Joho-an/Tennis-Robot/BTgamepad/引脚定义.png

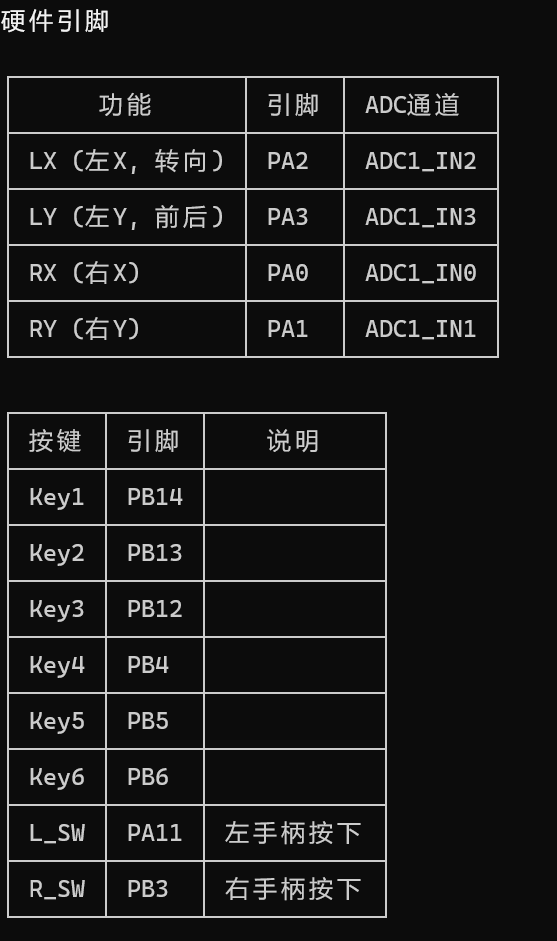
BTgamepad/引脚定义.png
