Joho-an/Tennis-Robot/BTgamepad/蓝牙指令1.png

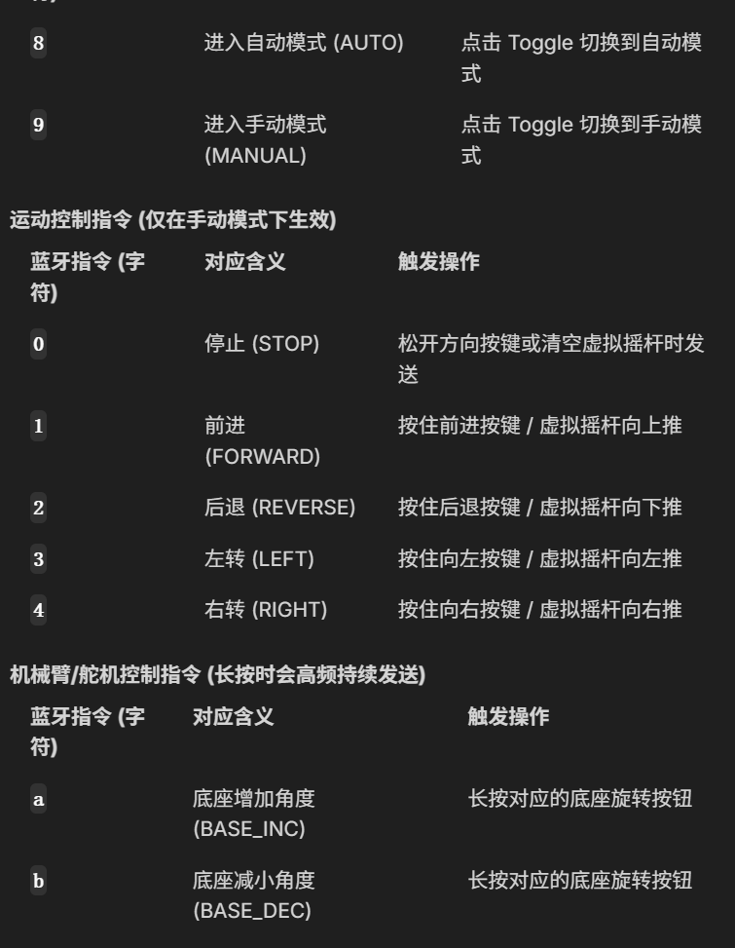
BTgamepad/蓝牙指令1.png
