Joho-an/Tennis-Robot/BTgamepad/蓝牙指令2.png

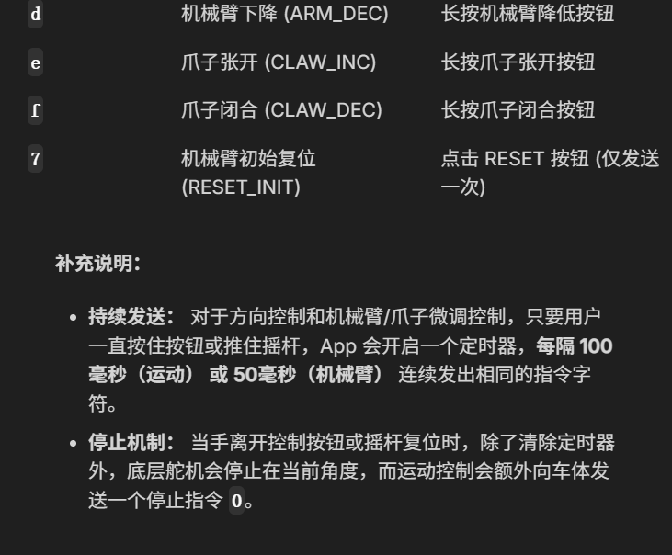
BTgamepad/蓝牙指令2.png
