Joho-an/Tennis-Robot/PCB/原理图.pdf

VSS 10 VDD 11 PH0-OSC_IN 12 PH1-OSC_OUT 13 NRST 14 PC0 15 PC1 16 PC2_C 17 PC3_C 18 VSSA 19 VREF+ 20 VDDA 21 PA0 22 PA1 23 PA2 24 PA3 25 VSS 26 VDD 27 PA4 28 PA5 29 PA6 30 PA7 31 PC4 32 PC5 33 PB0 34 PB1 35 PB2 36 PE7 37 PE8 38 PE9 39 PE10 40 PE11 41 PE12 42 PE13 43 PE14 44 PE15 45 PB10 46 PB11 47 VCAP 48 VSS 49 VDD 50 PB12 51

供电

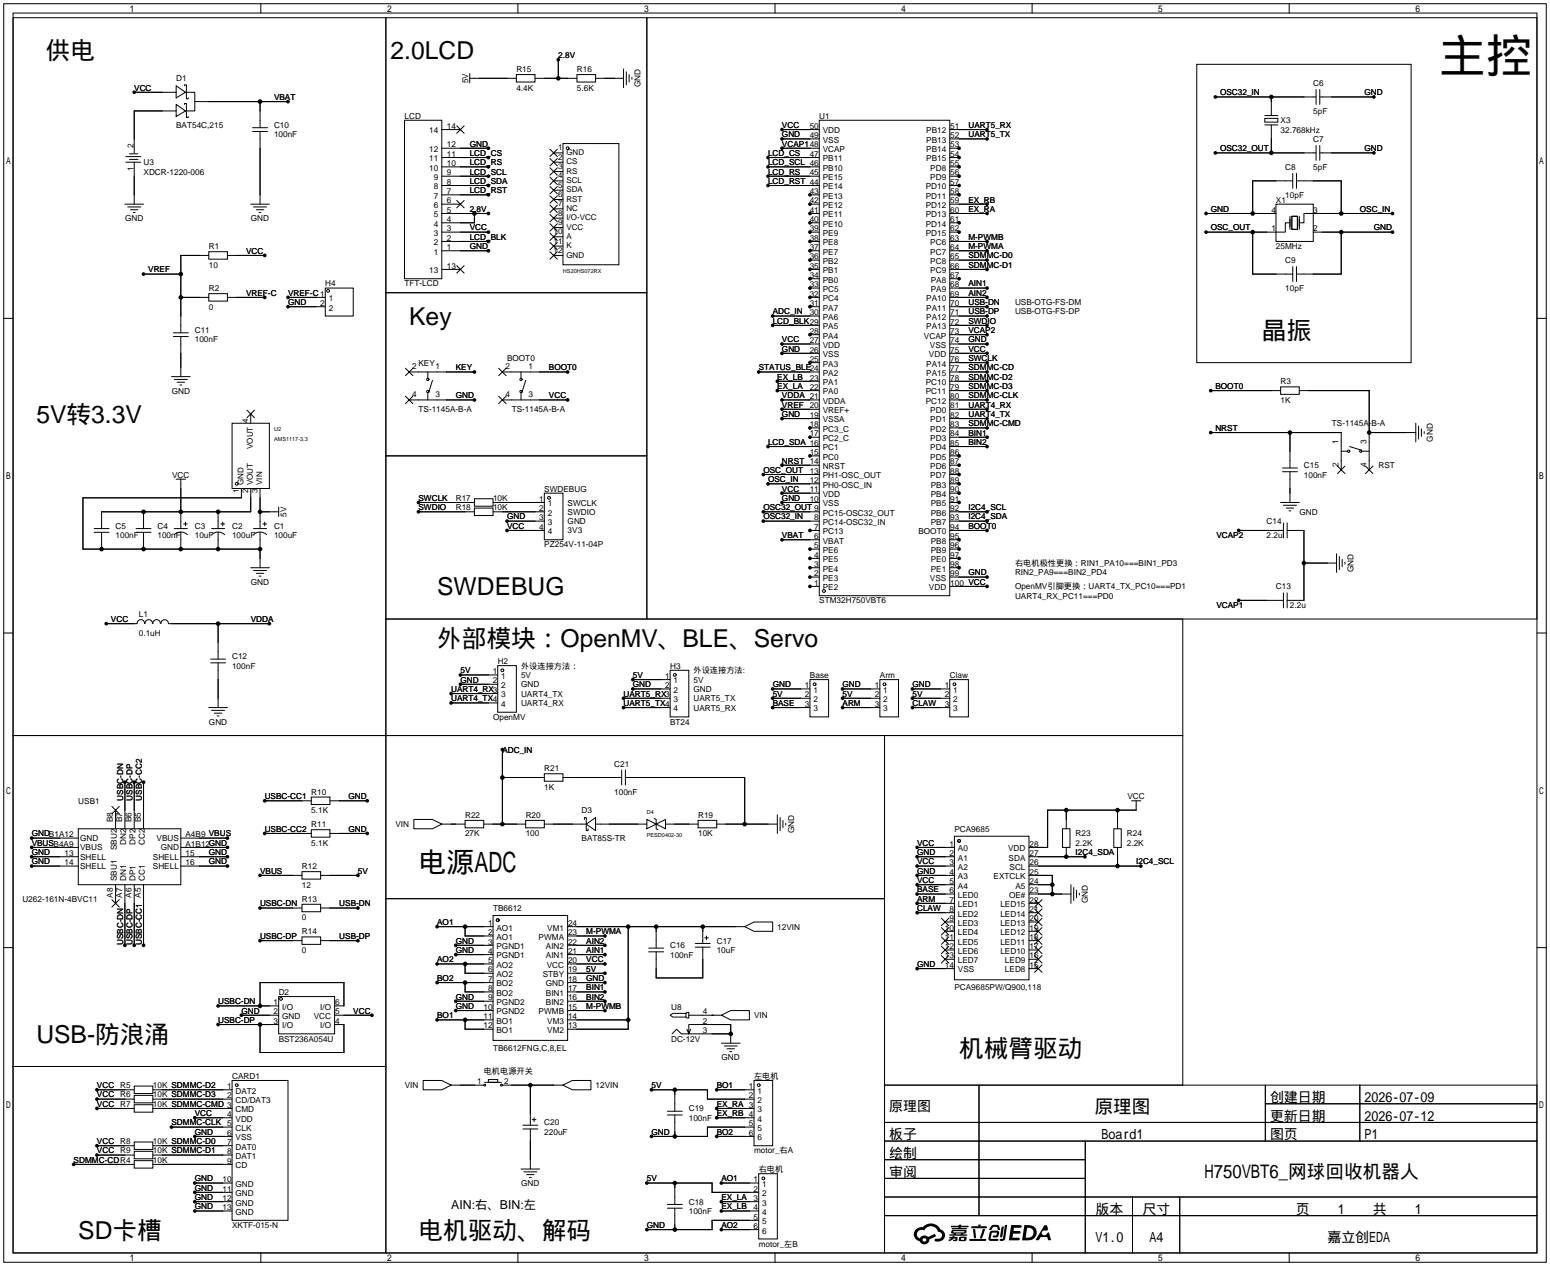
[picture p9: page 1]

USB-OTG-FS-DM
USB-OTG-FS-DP

原理图 | 原理图 | 创建日期 | 2026-07-09

更新日期 | 2026-07-12

板子 | Board1 | 图页 | P1
绘制 | | H750VBT6_网球回收机器人
审阅

V1.0 | A4 | 嘉立创EDA
