Joho-an/Tennis-Robot/(list of files, drawings)

Other design files:
PCB/PCBLayout.epro
PCB/原理图.epro
