Joho-an/Tennis-Robot/H7.ioc

Mcu.UserName=STM32H750VBTx
PA0.GPIO_Label=LeftA
PA0.Signal=S_TIM5_CH1
PA1.GPIO_Label=LeftB
PA1.Signal=S_TIM5_CH2
PA10.GPIO_Label=LIN1
PA10.Signal=GPIO_Output
PA11.Signal=USB_OTG_FS_DM
PA12.Signal=USB_OTG_FS_DP
PA2.GPIO_Label=status_ble
PA2.Signal=GPIO_Input
PA5.GPIO_Label=LCD_BLK
PA5.Signal=S_TIM2_CH1_ETR
PA6.Signal=ADCx_INP3
PA9.GPIO_Label=LIN2
PA9.Signal=GPIO_Output
PB10.Signal=SPI2_SCK
PB11.GPIO_Label=LCD_CS
PB11.Signal=GPIO_Output
PB12.Signal=UART5_RX
PB13.Signal=UART5_TX
PB6.Signal=I2C4_SCL
PB7.Signal=I2C4_SDA
PB8.Signal=SDMMC1_CKIN
PC1.Signal=SPI2_MOSI
PC10.Signal=SDMMC1_D2
PC11.Signal=SDMMC1_D3
PC12.Signal=SDMMC1_CK
PC6.GPIO_Label=Rmotor
PC6.Signal=S_TIM3_CH1
PC7.GPIO_Label=Lmotor
PC7.Signal=S_TIM3_CH2
PC8.Signal=SDMMC1_D0
PC9.Signal=SDMMC1_D1
PD0.Signal=UART4_RX
PD1.Signal=UART4_TX
PD12.GPIO_Label=RightB
PD12.Signal=S_TIM4_CH1
PD13.GPIO_Label=RightA
PD13.Signal=S_TIM4_CH2
PD2.Signal=SDMMC1_CMD
PD3.GPIO_Label=RIN1
PD3.Signal=GPIO_Output
PD4.GPIO_Label=RIN2
PD4.Signal=GPIO_Output
PE14.GPIO_Label=LCD_RST
PE14.Signal=GPIO_Output
PE15.GPIO_Label=LCD_DC
PE15.Signal=GPIO_Output
