Joho-an/Tennis-Robot/BTgamepad/Core/Inc/main.h

#define RX_Pin GPIO_PIN_0
#define RX_GPIO_Port GPIOA
#define RY_Pin GPIO_PIN_1
#define RY_GPIO_Port GPIOA
#define LX_Pin GPIO_PIN_2
#define LX_GPIO_Port GPIOA
#define LY_Pin GPIO_PIN_3
#define LY_GPIO_Port GPIOA
#define Key3_Pin GPIO_PIN_12
#define Key3_GPIO_Port GPIOB
#define Key2_Pin GPIO_PIN_13
#define Key2_GPIO_Port GPIOB
#define Key1_Pin GPIO_PIN_14
#define Key1_GPIO_Port GPIOB
#define LSW_Pin GPIO_PIN_11
#define LSW_GPIO_Port GPIOA
#define RSW_Pin GPIO_PIN_3
#define RSW_GPIO_Port GPIOB
#define Key4_Pin GPIO_PIN_4
#define Key4_GPIO_Port GPIOB
#define Key5_Pin GPIO_PIN_5
#define Key5_GPIO_Port GPIOB
#define Key6_Pin GPIO_PIN_6
#define Key6_GPIO_Port GPIOB
